Deeplab-Studio/TA-Tuner-Controller/schematic/SCH_Schematic.png

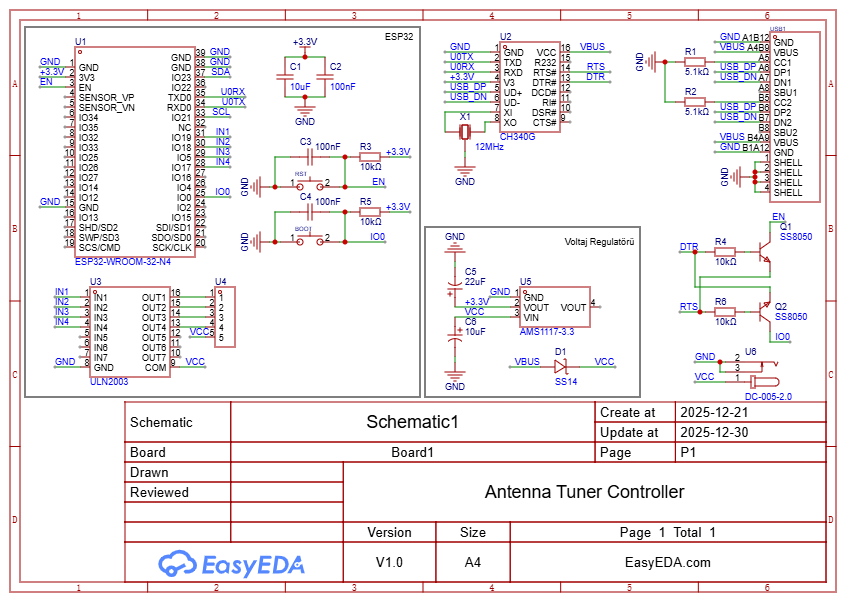
schematic/SCH_Schematic.png
