Deeplab-Studio/TA-Tuner-Controller/pcb/BOM_Board1_PCB1_2025-12-30.xlsx

No. | Quantity | Comment | Designator | Footprint | Value | Manufacturer Part | Manufacturer | Supplier Part | Supplier
1 | 2 | TS342A2P | BOOT,RST | SW-SMD_L4.0-W3.0-LS5.0-EH |  | TS342A2P | SHOU HAN(首韩) | C398055 | LCSC
2 | 1 | 10uF | C1 | C0805 | 10uF | CL21A106KAYNNNE | SAMSUNG(三星) | C15850 | LCSC
3 | 3 | 100nF | C2,C3,C4 | C0805 | 100nF | CC0805KRX7R9BB104 | YAGEO(国巨) | C49678 | LCSC
4 | 1 | 22uF | C5 | CAP-SMD_L3.5-W2.8-FD | 22uF | CA45-B-6.3V-220UF-M | CEC(振华新云) |  | LCSC
5 | 1 | 10uF | C6 | CAP-SMD_L3.5-W2.8-FD | 10uF | CA45-B-6.3V-220UF-M | CEC(振华新云) |  | LCSC
6 | 1 | SS14 | D1 | SMA_L4.3-W2.6-LS5.2-RD |  | SS14 | onsemi(安森美) | C83852 | LCSC
7 | 2 | SS8050 | Q1,Q2 | SOT-23-3_L2.9-W1.3-P1.90-LS2.4-BR |  | SS8050 | WPMtek(维攀) | C2688219 | LCSC
8 | 2 | 5.1kΩ | R1,R2 | R0805 | 5.1kΩ | RC0805FR-075K1L | YAGEO(国巨) | C84375 | LCSC
9 | 4 | 10kΩ | R3,R4,R5,R6 | R0805 | 10kΩ | RC0805FR-0710KL | YAGEO(国巨) | C84376 | LCSC
10 | 1 | ESP32-WROOM-32-N4 | U1 | WIFIM-SMD_ESP32-WROOM-32-N4 |  | ESP32-WROOM-32-N4 | ESPRESSIF(乐鑫) | C82899 | LCSC
11 | 1 | CH340G | U2 | SOIC-16_L9.9-W3.9-P1.27-LS6.0-BL |  | CH340G | WCH(南京沁恒) | C14267 | LCSC
12 | 1 | ULN2003 | U3 | SOP-16_L9.9-W3.9-P1.27-LS6.0-BL |  | ULN2003 | GR(国睿) | C18164408 | LCSC
13 | 1 | XY-XHB2.54-5A11 | U4 | HDR-TH_5P-P2.50-V-F-2 |  | XY-XHB2.54-5A11 | XYECONN(辛译) | C19271389 | LCSC
14 | 1 | AMS1117-3.3 | U5 | SOT-223-3_L6.5-W3.4-P2.30-LS7.0-BR |  | AMS1117-3.3 | AMS | C6186 | LCSC
15 | 1 | DC-005-2.0 | U6 | DC-IN-TH_DC-005-2.0_C22459640 |  | DC-005-2.0 | HanElectricity(瀚源) | C22459640 | LCSC
16 | 1 | TYPE-C16PIN | USB1 | USB-C-SMD_TYPE-C16PIN |  | TYPE-C16PIN | SHOU HAN(首韩) | C393939 | LCSC
17 | 1 | 12MHz | X1 | CRYSTAL-SMD_3P-L3.2-W1.3-P1.20-L-1 | 12MHz | CSTNE12M0G550000R0 | muRata(村田) | C341520 | LCSC
