Deeplab-Studio/TA-Tuner-Controller/3d model/Top Cover.stl

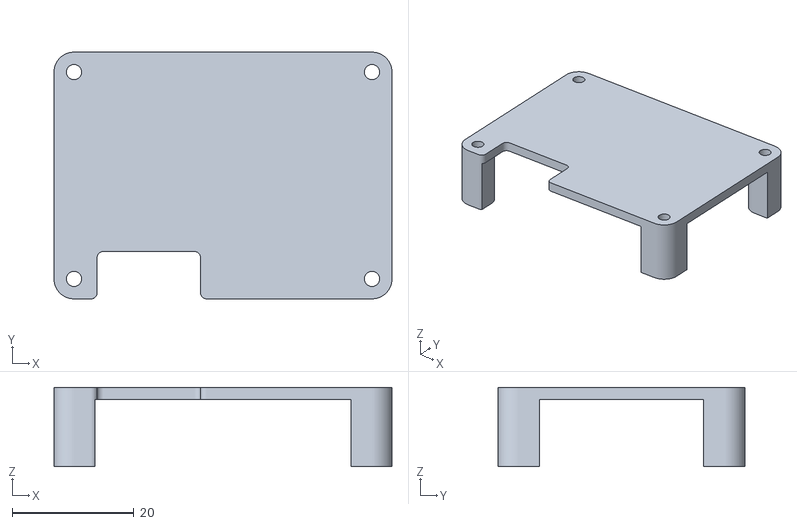
[picture p6: CAD file, 2025-12-30]
3d model/Top Cover.stl
55.6 x 40.6 x 13.0
