Deeplab-Studio/TA-Tuner-Controller/3d model/Bottom Cover.stl

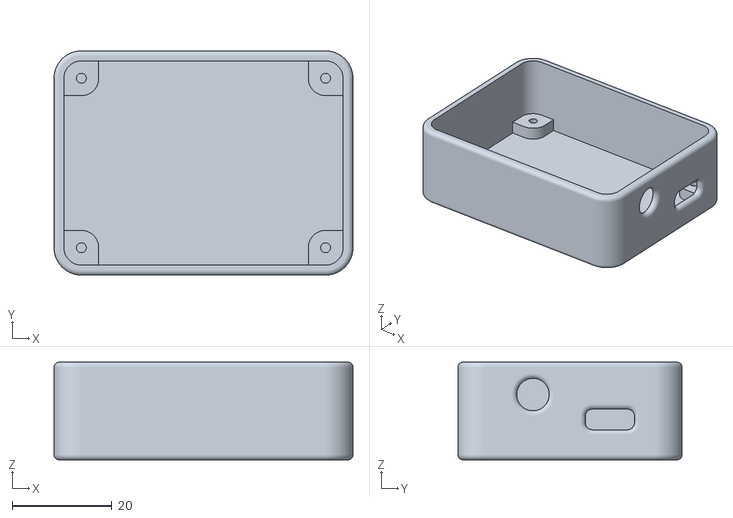
[picture p7: CAD file, 2025-12-30]
3d model/Bottom Cover.stl
60.0 x 45.0 x 19.6
