Deeplab-Studio/TA-Tuner-Controller/schematic/SCH_Schematic.pdf

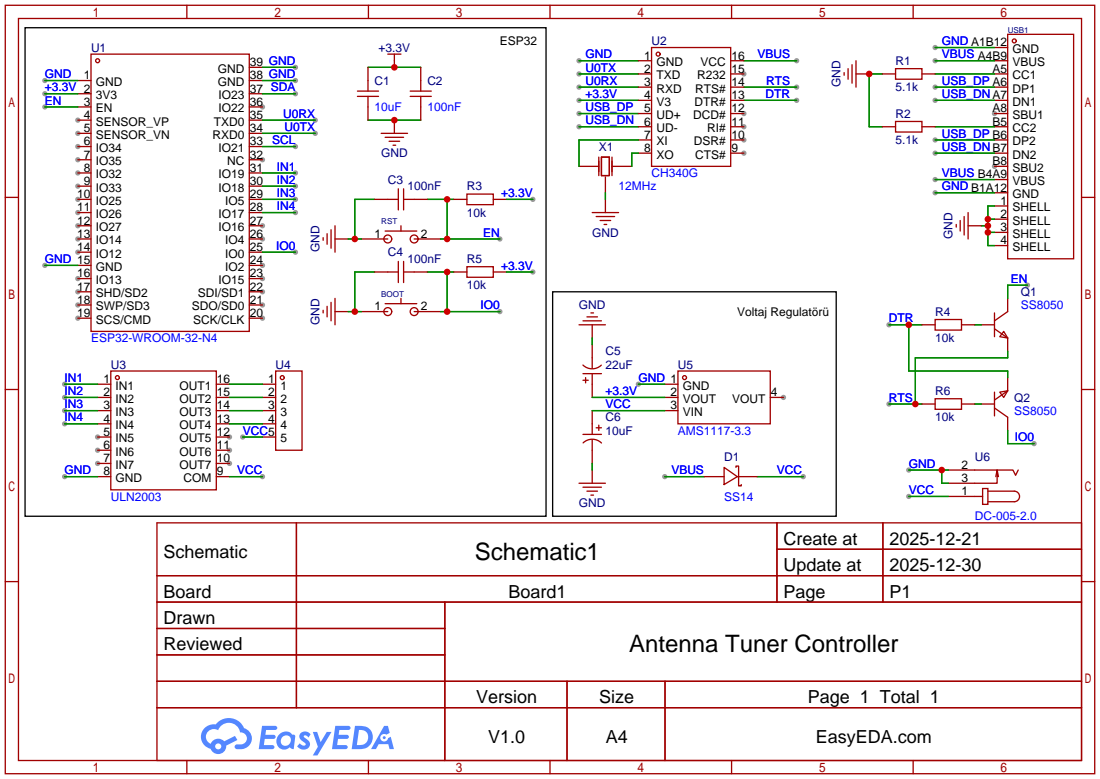
[picture p8: page 1]

DSR# 10 RI# 11 DCD# 12 DTR# 13 RTS# 14 R232 15 VCC 16

Schematic | Schematic1 | Create at | 2025-12-21

Update at | 2025-12-30

Board | Board1 | Page | P1
Drawn | | Antenna Tuner Controller
Reviewed

Version | Size | Page 1 Total 1
V1.0 | A4 | EasyEDA.com
