Deeplab-Studio/TA-Tuner-Controller/(commit log)

2025-12-30 First Upload
    [BOM_Board1_PCB1_2025-12-30.xlsx, Bottom Cover.stl, PickAndPlace_PCB1_2025-12-30.xlsx, Top Cover.stl]
2025-12-31 Update power supply specification in README
